gauteh/sonobuoy/doc/Instrument response/Response.pdf

Gautebøye - Instrument Response
Gaute Hope (gaute.hope@student.uib.no), 29.05.2012, Revision 3 (30.11.2012)

Introduction

Here is presented the theoretical derivation and analysis of the analog instrument response of the digitizer. The digital filtering during AD conversion is briefly discussed, but its properties are well defined in the manual of the ADC[ads1282ḋs ].

### 1 Hydrophone decoupling


Figure 1: Hydrophone decoupling circuit

The figure above (1) shows an equivalent circuit of the deployed input decoupling to the hydrophone.

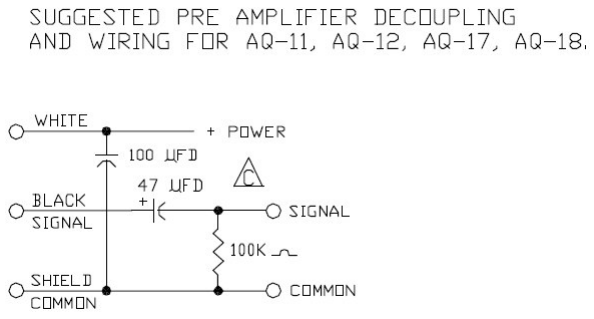
[picture p13: figure]

C1 = 47µF
C2 = 330pF
R1 = 58.33kΩ
R2 = 41.67kΩ

The circuit was based on the suggested decoupling in figure 2 seen below, it was designed to have the same properties, but also low-pass the signal at cutoff frequency fLP1
. The original design already decouples, and high-passes, the signal at frequency fHP .

1

Figure 2: AQ-18 suggested decoupling and wiring [aq-18ḋecoupling ].

### 2 Derivation of transfer function

i1 and i2 signify the current loops passing through respectively left and right loop. Using Kirchoff’s equation:

Vs = i1(ZC1 + ZR1

) + (i1 − i2) · ZR2

(1)
0 = (i2 − i1) · ZR2 + i2 · ZC2

(2)

Vs is the signal source, the hydrophone. See separate data sheet for hydrophone frequency response. Vo, output, is measured at the terminals T+ and

T−.

Vo = i2 · ZC2

(3)
H(s) = Vo
Vs
, s = iω | (4)

Solving for H(s) gives:

H(s) = | 51951s
(s + 1.2470 × 10⁵)(s + 0.2128) | (5)

A bode plot of the transfer function (instrument response) is shown in figure 3 below.


Figure 3: Bode plot of transfer function, showing peak response at 33.9 Hz.

Equation 5 can be solved by using the MATLAB script response.m (listing 1), the Bode plot in figure 3 was created with the same script.

### 2.1 Analysis

The initial frequency band of interest reaches from periods of 20 s (0.05 Hz) to approximately 100 Hz. The analog input part as well as the configuration of the analog-digital converter has been configured to as best and simple as possible to record the signal within this frequency band.

### 2.1.1 Decoupling and analog high pass fil-

ter

The transfer function is a bandpass filter with the suggested decoupling creating a high-pass filter with corner frequency at fHP = 0.0339 Hz or a period of 29.4985 s.

### 2.1.2 Low pass filter and operational am-

plifier

To avoid aliasing due to the speed of the opamps (operational amplifiers) in the signal path; the

2

OPA627 (see [opa627ḋs ] and figure 1) acting as buffer with unity gain and then the OPA1632 [opa1632ḋs ] at the input terminals of the ADS1282EVM [ads1282evmḋs ]. An additional low pass stage is added with a corner frequency of fLP1 = 17.189 kHz. The speed of the opamp is in the order of Mhz so this corner frequency should be well within their capabilities.

OPA1632
The OPA1632 [opa1632ḋs ] is set up with a 1 nF capacitor in its feedback loop on the ADS1282EVM [ads1282evmḋs ], this low passes the signal with an cut off frequency at fLP2 = 151.99 kHz. Its gain bandwidth is specified to be 180 MHz, given that the gain is 1 and the load is large it should have a well behaved and near ideal response. The OPA1632-setups simplified transfer function is [fullyḋiffȯpamps ]:

HOP A1632(s) = 9.551 × 10⁵
(s + 9.551 × 10⁵)

(6)

OPA627
The OPA627 is used as a buffer with gain 1 to provide a high impedance input and low impedance output. It has a gain bandwidth product of 16 MHz at this gain [opa627ḋs ]. With the first low pass filter, fLP1
, well below this it should be able to relay the signal without problems. The transfer function would simply be 1 for this step. It is important that the OPA627 has well mounted bypass capacitors to avoid oscillations when configured for this low gain. An buffer designed for unity gain, like the OPA633 [opa633ḋs ] or BUF634 [buf634ḋs ] could prove a better choice.

OPA633
The OPA633 [opa633ḋs ] is a strong candidate for an drop-in replacement of the OPA627, it is specifically designed to be a buffer working at unity gain. The feedback loop is internally connected. But otherwise the same wiring scheme applies. Closely mounted and well chosen bypass capacitors are still needed on the power supplies to ensure stability. The input impedance of the ADS1282EVM should be sufficient for the gain to approach unity. The OPA633 has a gain bandwidth of 260 MHz, however it requires ±15 mA current, which is about twice that of the OPA627.

### 2.1.3 Stability

The system, H(s) from equation (5), is passive and has all its poles in the left half plane and is stable.

### 2.1.4 Analog-Digital Converter (ADC)

The ADS1282EVM equips its ADS1282 with a crystal with the recommended clock frequency of fclk = 4.096 Mhz [ads1282evmḋs ]. This results in a modulator output speed of fs = fclk/4 = 1.024 Mhz [ads1282ḋs ]. The Nyquist frequency is then:

fN q = 1.024 × 10⁶
/2 = 512 kHz | (7)

3


Figure 4: Frequency response of complete analog system, equation (9).

### 2.1.5 Anti-alias filter

The 10 nF capacitor used on the ADS1282EVM [ads1282evmḋs ], results in a low-pass filter with an upper corner frequency of fLP3 =
1
2π×600×10×10⁻⁹ = 26525.82 Hz 1

fLP3

is thus well below fN q and any signal component above fLP3
should be almost completely damped before it reaches fN q, resulting in no or very small aliasing effects.
This equation represents the upper low pass filter:


HUL(s) = | 1 ÷ 600 × 10 × 10⁻⁹
| (s + 1 ÷ 600 × 10 × 10⁻⁹)
= | 1.667 × 10⁵
| (s + 1.667 × 10⁵)

(8)

The complete analog transfer function is then:

Ha =

8.2698 × 10¹⁵s
(s + 9.551 × 10⁵) × (s + 1.667 × 10⁵)

×

1
(s + 1.247 × 10⁵) × (s + 0.2128)

(9)

The frequency response is illustrated in figure (4).

### 2.1.6 Output of decoupling and buffer

The output is scaled by −7.6 dB = 0.4169 V
V
which is to scale the input from ±6V to ±2.5V , 0.4169 ≈ 5/12 = 0.4167, which is the input range of the ADS1282EVM ([ads1282evmḋs ] and [ads1282ḋs ]) in bipolar mode. The slightly inaccurate scaling is due to the available (high precision) resistor values.

The impulse response of the system is plotted in figure 5:

1Equation (3), p.15, [ads1282ḋs ]; ads1282ḋs

4

Figure 5: Impulse response of complete analog system, equation (9).

The step response, large is plotted in figure 6:


Figure 6: Step response of complete analog system, equation (9).

A | zoomed | in | section | of | the | high
frequency | response | is | shown | in | fig-
ure | 7, | the | first | tens | of | microseconds.


Figure 7: Step response (zoomed) of complete analog system, equation (9).

Attenuation at Nyquist frequency
The attenuation at the Nyquist frequency, 512 kHz, equation (7) using (9), is evaluated to be:

|Ha(512 × 10³ × 2π)| = 0.00023763

= −72.4821 dB

(10)

The theoretical maximum dynamic range is specified to be 130 dB²
. But before reaching the frequencies of any signals not attenuated at (10) that wraps around to the 125 Hz passband of the digital filter (section 7) they will be additionally attenuated. The next periods will be increasingly attenuated.

Depending on the noise spectra there will be only a fraction of the noise that is in this passband. Any tones or oscillations from the electrical components or environment are, although unlikely to be entirely in this passband, the biggest worry. Other noise is likelier to have a flatter spectra, where only a fraction of its amplitude will wrap into the 125 Hz passband.

### 3 Digital filter

Further the ADS1282 is configured to digitally filter the decimation output so that the final output signal of 250 Hz contains no alias below the input Nyquist sample rate (equation (7)). The built-in sinc and FIR filters are activated, see the ADS1282 datasheet [ads1282ḋs ] for details. This provides more than 140 dB of attenuation above the Nyquist frequency of the output sample rate [ads1282ḋs ].

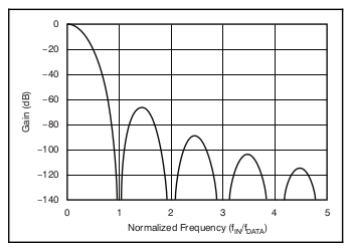
[picture p14: figure]

Figure 8: Sinc filter response [ads1282ḋs ].

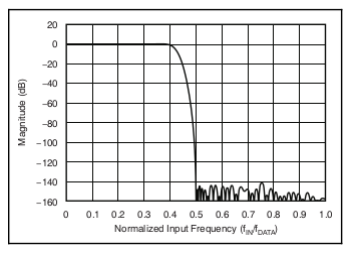
[picture p15: figure]

Figure 9: FIR filter response [ads1282ḋs ].

Figure 8 shows the response of the sinc filter, figure 9 shows the response of the FIR filter (figures from ads1282ḋs pp. 20 - 21 [ads1282ḋs ].

The ADS1282 can be configured for an sample rate of as high as 4000 Hz [ads1282ḋs ]. This would be possible without changes in the analog

2Table 1, p. 13, [ads1282ḋs ]; ads1282ḋs

5

interface, although it would come at an cost of resolution and would require adaption of the firmware of the buoy to handle the higher data rate.
High Pass Filter (HPF) The ADS1282 is configured to have an high pass corner frequency as close to 20 seconds as possible, the built in IIR HPF is set according to p. 22 in ads1282ḋs

HP F[1 : 0] = 65, 536×
"
1 −

s
1 − 2

cos(ωn) + sin(ωn) − 1
cos(ωn)
(11)

with:

ωn = 2πfHP /fDAT A | (12)
An fHP | = 1/20 = 0.05 Hz gives an ωn | =
0, 001256637 normalized radians. And an HP F[1 : 0] = 82.3550098 truncated to HP F[1 : 0] = 8210 = 5216.

### 4 Hydrophone characteristics

The | hydrophone | used, | Benthos | AQ-18, | is
specified to have an flat frequency response within ±1.5dB at the band 7 Hz - 10 kHz [benthosḣydrophoneḃrochure ]. With a sensitivity of -171 dBv re 1 uPa at 20◦ C.

The frequency response for the AQ-18 is plotted in figure 10:

Figure 10: Frequency response plot of hydrophone, AQ-18 [communicationḃenthosȧq18ḟreq ].

A simplified transfer function for the hydrophone in the flat band (7 Hz - 10 kHz):

HHyd = −171 dBv re 1 uPa = 10⁸.55 V uPa (13)

### 5 Response of Digitizer

The AD converter, ADS1282, includes very sharp digital filters (section 3). The output is 32 bit integers, with a range of -−2

31
, 2

31 − 1

. The result is
a near approximately flat frequency response from 0.05 Hz up to 125 Hz.

HD =

2

32
5

counts
V

(14)

### 6 Response compared to output of a

seismometer

The hydrophone measures pressure (uPa) while the seismometer measures displacement (nm), to be able to compare these some relation has to be figured out.

Considering that a force is exerted proportional to the pressure the hydrophone is measuring and that acceleration is proportional to force the simplest is to consider the hydrophone an accelerometer.

6

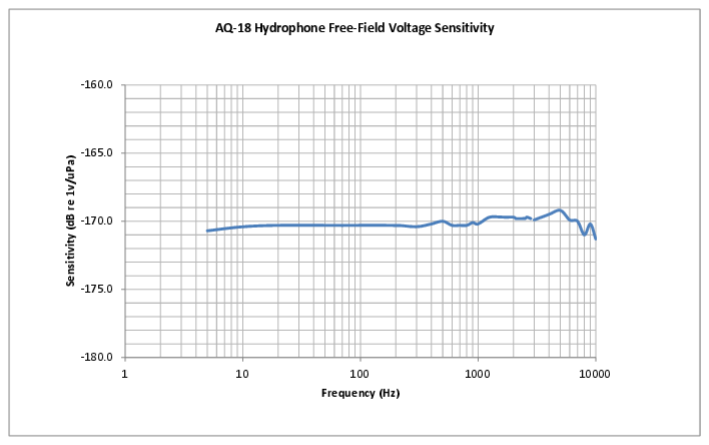
[picture p16: figure]

### 7 Attachments

### 7.1 response.m

Listing 1: response.m, MATLAB code for calculating instrument response

1 | % Calculates instrument response
2 | r1 = 58.33e3; | % ohm
3 | r2 = 41.67e3; | % ohm

4
5 | c1 = 47e-6; | % farad
6 | c2 = 330e-12; | % farad

7
8 | %% Transfer function of Hydrophone decoupling, including first high pass and low
9 | % | pass filters and OPA629.

10
11 | syms s i1 i2 vs;
12 | zc1 = 1/(s*c1);
13 | zr1 = r1;
14 | zc2 = 1/(s*c2);
15 | zr2 = r2;

16
17 | [i1, i2] = solve ('vs = i1*(zc1 + zr1) + (i1 - i2)*zr2', ...
18 | '0 | = (i2 - i1)*zr2 + i2*zc2', 'i1', 'i2');
19 | %i2 = solve ('vs = i2*(zc1 + zr1 + zr2)', 'i2');

20
21 | vo = i2*sym('zc2');
22 | H | = vo/vs;
23 | H | = simplify(subs (H));

24
25 [n, d] = numden (H);

26
27 | Tn = sym2poly(n);
28 | Td = sym2poly(d);
29 | T = tf(Tn, Td);

30

31
32 | P = bodeoptions;
33 | P.FreqUnits = 'Hz';
34 | figure(1); clf('reset');
35 | bodeplot (T, P);
36 | title ('Bode plot of hydrophone decoupling with initial low pass and OPA629');

37
38 | disp ('Hydrophone decoupling up to OPA629:')
39 | zpk(T)
40 | if isstable(T)
41 | disp ('System is stable.');
42 | else
43 | disp ('System is unstable.');
44 | end

45
46 | %% opa1632 low pass
47 | disp ('OPA1632. low passing:');
48 | UOPA = zpk([], [-(1/(1047*10ˆ-9))], 1/(1047*10ˆ-9))
49 | figure(4); clf('reset');
50 | bodeplot (UOPA, P);
51 | title ('Bode Diagram (OPA1632)');

52
53 | %% upper low pass
54 | disp ('Upper low pass (ADS1282, analog):');
55 | U = zpk([], [-(1/(600*10*10ˆ-9))], 1/(600*10*10ˆ-9))
56 | figure(2); clf('reset');
57 | bodeplot (U, P);
58 | title ('Bode Diagram (Upper low pass filter)');

59
60 | %% final response
61 | disp ('Final response:');
62 | C = UOPA * U * T
63 | figure(3); clf('reset');

7

64 | bodeplot (C, P);
65 | title ('Bode Diagram (Complete analog response)');

66
67 | % Stable
68 | if isstable(C)
69 | disp ('System is stable.');
70 | else
71 | disp ('System is unstable.');
72 | end
73 | figure(5);
74 | [p, z] = pzmap(C);
75 | pzmap(C);
76 | disp ('Poles:')
77 | disp(p)

78
79 | % attenuation at nyquist
80 | disp ('Attenuation at Nyquist:');
81 | a = abs(freqresp(C, 512e3*2*pi))
82 | adb = 20*log10(a)

8
