gauteh/sonobuoy/zero/README.txt

Contents:

  zero.py:
  Central logging point (Zero), manages buoys, synchronizes and
  retrieves status.

  ztool.py:
  Command line interface for sending commands, retrieving status and
  monitoring buoys from Zero.

  log/:
  Local storage of buoy data, Zero writes data here.

  snap/:
  Firmware for RF200 connected for RF200 device connected to Zero
  through USB.

  storetools/:
  Tools for processing data files.

  matlab/:
  Scripts for working with data files in MATLAB.

  utils/:
  Scripts and programs for preparing SD card, backing up and testing.

  zui/:
  Unfinished graphical user interfaces.
