gauteh/sonobuoy/doc/Instrument response/pzmap.png

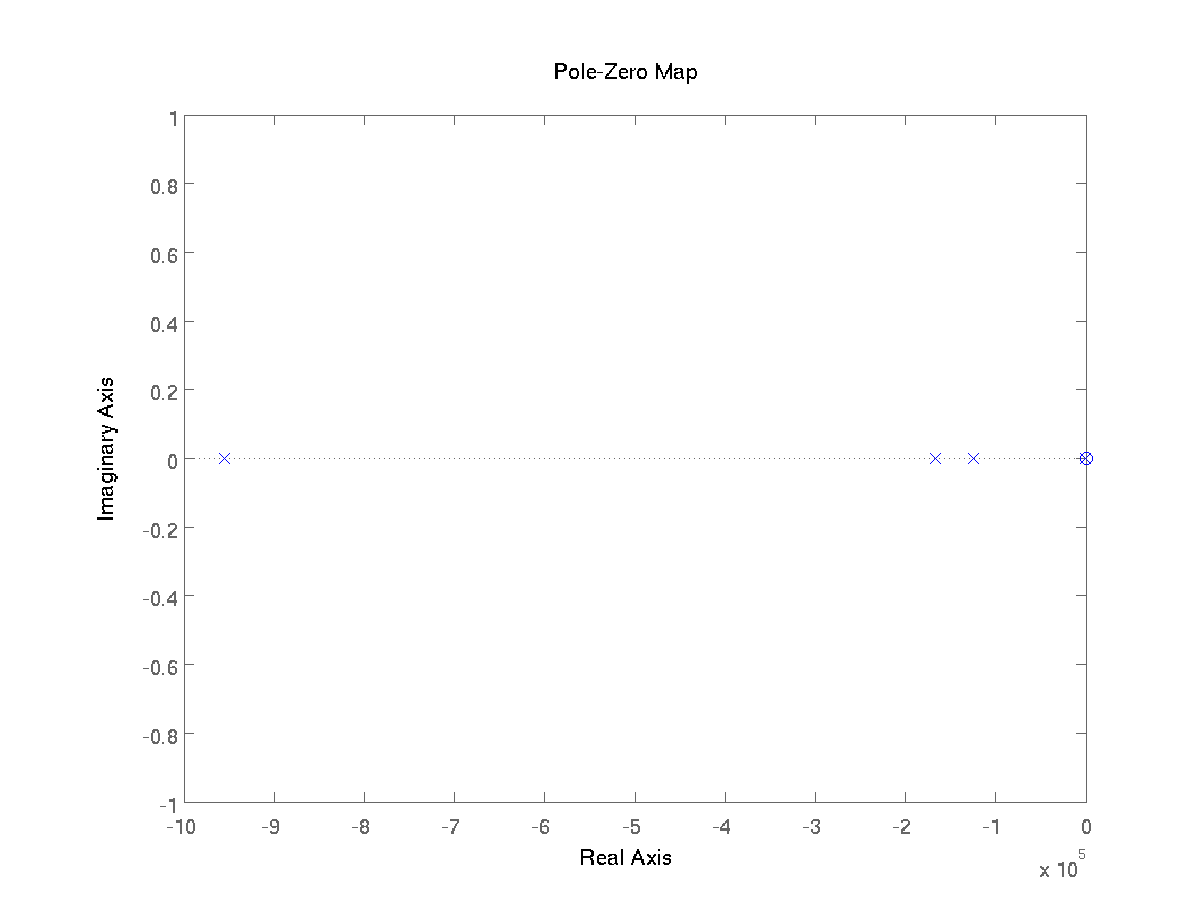
doc/Instrument response/pzmap.png
