gauteh/sonobuoy/hardware/Parts.ods

 | Node component list
Qty | Part no. | Name | Comment | NOK | USD | Supplier
1 |  | Olimexino STM32 H103 |  |  | $75,00 | Mouser
1 | EM-406A SiRF III | GPS with PPS |  | kr 443,00 |  | ELFA
1 | RF200PD1 | Synapse RF transciever |  |  | $27,00 | Future Electronics / Solarobotics
1 | 39252 | Synapse Breakout Board |  |  |  | Solarobotics
 | SN171GG-N | SNAP ProtoBoard |  |  | $42,00 | Future Electronics
 |  | RF power amplifier |  |  | $180,00 | Radiolabs
1 |  | RF Antenna 15 dBi Omnidirectional |  |  | $150,00 | Radiolabs
1 |  | 16 GB microSD card (high quality) |  |  | $33,00 | Komplett
1 | ADS1282EVM | ADC 24bit evaluation board |  |  | $49,00 | Mouser
2 | TSS-110-03-L-D | ADS1282EVM Headers 20 pin |  |  |  | Samtec
1 | TSS-105-03-L-D | ADS1282EVM Headers 10 pin |  |  |  | Samtec
1 |  | Hydrophone
1 |  | Battery 12V 100Ah |  |  | $250,00
1 |  | Box
 | Power regulation and preamp/buffer
1 | TEN 5-1222 | DC / DC 9 – 18 -> +/- 12V |  |  | $86,00 | ELFA
1 | LM2674N-5.0 | Switching voltage reg +5V |  |  |  | Mouser
1 | TL751L | Voltage reg +10V |  |  |  | Mouser
1 | LM2991 | Voltage reg -10V |  |  |  | Mouser
1 | LF60ABV | Voltage reg +6V |  |  |  | Mouser
1 | LM2991 | Voltage reg -6V |  |  |  | Mouser
1 | TLE2426 | Virtual ground (Agnd) |  |  |  | Mouser
1 |  | Voltage reg -5V |  |  |  | Mouser
2 | 1 uF | Solid Tantulum | LM2991
2 | 2,4kOhm | Adjustment (1%) | LM2991
1 | 9,5kOhm | Adjustment (1%) | LM2991 (-6V)
1 | 17,6kOhm | Adjustment (1%) | LM2991 (-10V)
1 | Diode 50V, 3.3A | Schottky 50V, 3.3A | LM2674 |  |  | IR30WQ05F
1 | 22 uF | 50V Tantulum (Cin) | LM2674 |  |  | Sprague 199D series
1 | 100 uF | 25V Tantulum (Cout) | LM2674 |  |  | Sprague 595D series
1 | 68 uH | Sumida (Lout) | LM2674
1 | 0.01uF | 50V Ceramic (Cb) | LM2674
1 | 10 uF | Cin | LF60ABV
1 | 2.2uF | Cout | LF60ABV
1 | 41.67 kOhm | Voltage scaling, preamp (hi-prec) | Preamp
1 | 58.33 kOhm | Voltage scaling, preamp (hi-prec) | Preamp
1 | 380 pF | LP filter preamp | Preamp
2 | 0.1 uF | Opamp power bypass | Preamp
2 | 2.2uF | Opamp power bypass | Preamp
1 | OPA620 | Buffer (alt: LM833N) | Preamp |  |  | Mouser
2 | 4,7kOhm |  | Pull-up I2C
2 | 100 uF
 | Logging point component list
1 | RF200PD1 | Synapse RF transciever |  |  | $40,00 | Future Electronics / Solarobotics
1 |  | RF Antenna 15 dBi Omnidirectional |  |  | $150,00 | Radiolabs
1 |  | RF power amplifier |  |  | $180,00
1 | SN132HO-NR | SNAPStick USB module |  |  | $37,23 | Future Electronics
 |  | Logging computer (Linux)
