gauteh/sonobuoy/hardware/Olimexino - pin map and configuration.ods

Olimexino pin map
Olimexino
GND | DGND
Vin | +12V
RST | Reset | 20 | RF200, GPIO18 | Active LOW, break out to shield and to RF200
RF200 |  | Olimexino |  | USART1
Pin | Pin name | Pin | Pin name
GPIO8 | TX (XBTX) | 8 | 1_RX
GPIO7 | RX (XBRX) | 7 | 1_TX
GPIO18 | [20] | RST | Reset
Vdd | +3.3V
GND | DGND
GPS |  | Olimexino |  | USART2
Pin | Pin name | Pin | Pin name
1, Black | DGND
2, White | +5V
3, Yellow | RX | NC
4, Blue | TX | 0 | 2_RX | 5V tolerant
5, Red | DGND
6, Green | PPS | 2 | Interrupt, EXTI0 | 5V tolerant | EXTI: D2, D15, D27
SD |  | Olimexino |  | SPI2
Pin | Pin name | Pin | Pin name
MOSI |  | 33 | 2_MISO | 5V tolerant | Onboard SD-header on SPI2
MISO |  | 34 | 2_MOSI
SS |  | 25
SCK |  | 32 | 2_SCK
ADS1282EVM |  | Olimexino |  | I2C1, SPI1
Pin | Pin name | Pin | Pin name
J5.9 | nDRDY | 4 | Interrupt, EXTI5 |  | EXTI: D4, D13, D20
J5.3 | SCLK | 12 |  |  | SPI
J5.11 | DIN | 10
J5.13 | DOUT | 11
J5.16 | SCL | 5 | 1_SCL | Pullup to 3.3V | I2C
J5.20 | SDA | 9 | 1_SDA | Pullup to 3.3V
Analog inputs
J6.1 | A1N | Vref | TLE2426 | Agnd
J6.2 | A1P | Vs | Opamp output | Agnd +/-2.5V
Power |  | Board | Olimexino
J8.1 | +10VA | +10VA |  |  | Power supply
J8.2 | -10VA | -10VA
J8.3 | +5VA | +5VD |  | (max. +5V)
J8.4 | -5VA | -6VA |  | (min. -10V)
J8.5 | DGND | DGND |  | Is not used for Avss internally
J8.6 | AGND
J8.7 | +1.8VD | NC
J8.8 | VD1 | NC
J8.9 | +3.3V | +3.3V | Vcc (3.3V)
J8.10 | +5V | NC
Jumpers and switches
J1 | REF | 1&2 | Set on-board reference to output of REF5050
J2 | CLK | 1&2 | Use on-board clock to drive ADS1282
J3 | CLKSEL | 2&3 | Set to DVDD (always on), turn on-board clock on
S1 | S1 | Onbrd | Use on-board reference
J10 |  | 1&2 | Enable DIN
J7.12 | ADC_AVDD | Yes | Power +5V to +2.5V
J7.34 | ADC_AVSS | Yes | Power -5V to -2.5V
J7.56 | +3.3V | Yes | Has 3.3V digital supply
J7.78 | AGND | Yes | Agnd = Dgnd, internally new Avss is created from +/-5VA
J7.910 | DGND | Yes
