gauteh/sonobuoy/hardware/MapleNativeBeta - pin map and configuration.ods

Maple Native Beta pin map
Maple
GND | DGND
Vin | +5V | (or as close to +3.3V as possible)
RST | Reset | Active low, break out to shield
RF200 protoboard |  | Maple
GPIO8 | TX | 1 | RX3
GPIO7 | RX | 0 | TX3
Vext | +5V
GND | DGND
GPS |  | Maple
Black | DGND
White | +5V
Yellow | NC
Green | PPS | 25 | Interrupt
Blue | DGND
Red | TX | 27 | RX5
SD |  | Maple
+5V | +5V
GND | DGND
MOSI |  | 5 | MISO
MISO |  | 4 | MOSI
SS |  | 2 | SS
SCK |  | 3 | SCK
ADS1282EVM |  | Maple
J5.3 | SCLK | 53 | SCLK |  | Serial interface
J5.9 | nDRDY | 40 | Interrupt
J5.11 | DIN | 54 | DIN (output)
J5.13 | DOUT | 55 | DOUT (input)
J5.16 | SCL | 38 | I2C clock | Pullup to 3.3V
J5.20 | SDA | 39 | I2C data | Pullup to 3.3V
Analog inputs
J6.1 | A1N | Vref | TLE2426 | GND +6V
J6.2 | A1P | Vob | Opamp output | GND +6V (+-2.5V)
Power |  |  | Maple
J8.1 | +10V | +6V |  |  | Power supply
J8.2 | -10V | -6V
J8.3 | +5V | +6V
J8.4 | -5V | -6V
J8.5 | DGND | DGND
J8.6 | AGND | DGND
J8.7 | +1.8VD | NC
J8.8 | VD1 | NC
J8.9 | +3.3V | +3.3V | Vcc (3.3V)
J8.10 | +5V | NC
Jumpers and switches
J1 | REF | 1&2 | Set on-board reference to output of REF5050
J2 | CLK | 1&2 | Use on-board clock to drive ADS1282
J3 | CLKSEL | 2&3 | Set to DVDD (always on), turn on-board clock on
S1 | S1 | Onbrd | Use on-board reference
J10 |  | 1&2 | Enable DIN
J7.12 | ADC_AVDD | Yes | Power +5V to +2.5V
J7.34 | ADC_AVSS | Yes | Power -5V to -2.5V
J7.56 | +3.3V | Yes | Has 3.3V digital supply
J7.78 | AGND | Yes | Use AGND as DGND
J7.910 | DGND | No | Connected by J7.78
