gauteh/sonobuoy/doc/Protocol.ods

Protocol
Buoy, receive | Version | Token | Arguments
GETSTATUS | 1 | GS |  |  |  |  | Returns an AD,S and GPS,S message
GETINFO | 2 | GIF |  |  |  |  | Returns info about buoy
GETIDS | 1 | GIDS | id |  |  |  | Returns IDS message starting from specified ID up to pre-determined number of IDS
GETLASTID | 1 | GLID |  |  |  |  | Returns an LID message
GETBATCH | 1 | GB | id | ref no | start | length | Returns an AD,D message, batch and AD,DE message
 |  |  | Send samples from index and datafile with 'id' | Start from reference number in datafile 'id' | Send samples from 'start' sample relative to reference number | Send 'length' number of samples from 'start' | With a length longer than one batch (reference) the following are sent subsequentially – if the length exceeds the number of references (batches) on this ID a E_NOSUCHREFERENCE error is sent. And no batches are sent.
Deprecated:
GETID | 1-3 | GID | id |  |  |  | Return IND message
Buoy, transmit | Version | Token | Values
GETSTATUS
AD STATUS | 1 | AD,S | queue position | batch fill time | current value
GPS STATUS | 1 | GPS,S | last telegram type | No of received telegrams | latitude | north / south | longitude | east/west | lastsecond | time | date | valid | HAS_TIME | HAS_SYNC | HAS_SYNC_REFERENCE
 |  |  |  |  |  | 'N' or 'S' |  | 'E' or 'W' | Time and date converted to unix time, possibly updated by PPS pulse. Used for reference. |  |  | GPS fix reported valid by GPS | True if current reference has valid time | True if there is a valid PPS signal | True if reference could be set by valid time and PPS signal
GPS STATUS | 2 | GPS,S | last telegram type | No of received telegrams | latitude | north / south | longitude | east/west | lastsecond | time | date | valid | HAS_TIME | HAS_SYNC | HAS_SYNC_REFERENCE | uptime
 |  |  |  |  |  | 'N' or 'S' |  | 'E' or 'W' | Time and date converted to unix time, possibly updated by PPS pulse. Used for reference. |  |  | GPS fix reported valid by GPS | True if current reference has valid time | True if there is a valid PPS signal | True if reference could be set by valid time and PPS signal | Millis (), will wrap around eventually, returns ms since start
GETINFO
INFO | 2 | I | buoy id | buoy version | protocol version
INFO | 3 | I | buoy id | buoy version | protocol version | store version
GETLASTID
LAST ID | 1 | LID | current id
GETID
INDEX (header) | 1 | IND | id | samples | no of refs
INDEX (header) | 3 | IND | id | store version | samples | no of refs
INDEX (header) | 4 | IND | id | store version | samples | no of refs | sd lag
GETBATCH
Start of data | 1 | AD,D | id | refno | start | length | ref | refstat | latitude | longitude | checksum (32bit)
 |  |  |  |  |  |  | Both ref and refstat is 0 if start != 0, 32 bit checksum is recorded by ads1282 and stored along with the reference
Start of sampels |  | $ |  |  |  |  | Signals start of binary data, no following newline
Samples (binary) |  |  |  |  |  |  | Samples sent as binary data, length * sample length (4 bytes) must be read.
End of data |  | AD,DE | checksum |  |  |  | Checksum XOR of binary data, 8 bit
Error messages:
ERROR | <=1 | $ERR | error code
ERROR | 2 | $ERR | buoy id | error code
Error codes (defined in rf.h and buoy.py):
E_CONFIRM | 1 |  | 0 | Not used
E_BADCOMMAND | 1 |  | 1 | Bad arguments have been given or the command can somehow not be executed
E_UNKNOWNCOMMAND | 1 |  | 2 | An unknown command
E_SDUNAVAILABLE | 1 |  | 3 | The SD card is not available, reflects: store->SD_AVAILABLE
E_NOSUCHID | 1 |  | 4 | The id requested (e.g. by GETID or GETBATCH) does not exist
E_NOSUCHREF | 1 |  | 5 | The ref requested by GETBATCH does not exist
E_NOSUCHSAMPLE | 1 |  | 6 | The sample does not exist, the data file does not contain enough samples
E_NOSUCHDAT | 1 |  | 7 | The dat file does not exist or cannot be opened
E_BADDAT | 1 |  | 8 | There was an error reading and sending the DAT file
E_SDLAG | 1 |  | 9 | SD card could not write queue fast enough, samples may be out of sync and lost.
E_MAXIDREACHED | 2 |  | 10 | The highest ID has been reached, the latest will be overwritten on each new file.
Deprecated:
GETREFS
REFERENCES of ID | N/A | REF | id | ref no | ref
GETIDS
LIST OF IDS | 1-3 | IDS | id | enabled |  |  | Enabled (1 or not: 0) indicates wether this index/datafile exists
