gauteh/sonobuoy/doc/Operators manual/OperatorsManual.pdf

Gautebøye - Operators manual
Gaute Hope (gaute.hope@student.uib.no), 02.09.2012, Revision 1

Introduction

This document describes how to install and operate a network of Gautebøyer.

### 1 Installation

### 1.1 Central logging point: Zero

Zero is the central logging point and is started by running the script ’zero/zero.py’ from the command line.

### 1.1.1 ZeroNode

For the central logging point you need a computer connected to an RF200 node through USB with the snap script ’zero/snap/zeronode.py’ installed.

### 1.2 Buoy

### 2 Monitoring

1
