gauteh/sonobuoy/hardware/Power measurements, Olimexino.ods

Power circuit, rev 2
Incremental measurements while prototyping circuit, source: 12V DC, measured value is output current on source.
Part | mA | Rated efficiency | Comment
TEN 5-1222 | 20 | 84
TL751L (+10V LDO) | 10
LM2674N-5.0 (+5V Switch reg)
LF60ABV (+6V LDO)
LM2991 (-10V LDO) | 5 |  | (using 2,4k and 1,76k adjustment resistors)
LM2991 (-6V LDO) |  |  | (using 2,4k and 9,5k adjustment resistors)
Olimexino STM32 H103 | 40 |  | (no processing)
TLE2426 (Avss) | 0
Sum | 75
TEN 5-1222 | 70
TL751L (+10V LDO)
78SR105 (+5V Switch reg)
Olimexino STM32 H103
LM2991 (-10V LDO) | 10
LM2991 (-6V LDO)
LF60ABV (+6V LDO)
TLE2426 (Avss)
ADS1282EVM | 80 |  | (full operation) (using +/- 12V and a LDO -5V gives ca same result)
SD card | 0
GPS | 20 |  | No fix
RF | 30 |  | (full operation)
Preamp + Hydrophone | 10
Sum | 220
