gauteh/sonobuoy/hardware/Power measurements, MapleNativeBeta.ods

Power budget [mA]
 | 3,3 | -5 | 5 | -12 | 12
Power rails
Sum | 0 | 0 | 0 | 0 | 0
Power | 0 | 0 | 0 | 0 | 0
Current (at 12V) | 0 | 0 | 0 | 0 | 0
Measured (peak) |  |  |  |  |  | Idle
 | 3,3 | -5 | 5 | -12 | 12 | 3,3 | -5 | 5 | -12 | 12
RF200 |  |  | 35 |  |  |  |  | 35
RF200 protoboard
GPS |  |  | 55 |  |  |  |  | 55
SD card |  |  | 22 |  |  |  |  | 9
ADS1282-EVM (analog) |  | 0 | 8
Maple Native |  |  | 112 |  |  |  |  | 112
ADS1282-EVM (digital) | 60
ADS1292-EVM (opamp) |  |  |  | -30 | 34
Hydrophone w/ preamp
Opamp / buffer |  | -4,3 | 4
Sum | 60 | -4,3 | 201 | -30 | 34 | 0 | 0 | 176 | 0 | 0
Power | 198 | 21,5 | 1005 | 360 | 408 | 0 | 0 | 880 | 0 | 0
Current (at 12V) | 16,5 | 1,79 | 83,75 | 30 | 34 | 0 | 0,00 | 73,33 | 0 | 0
External input (12V) | 370
From 12/12 DC summing
Maple Native | 90
RF200 | 120
ADS1282EVM | 160 | 230
SD |  | 240
GPS |  | 300
