gauteh/sonobuoy/doc/Buoys/Tests/One/1hz_10_hz_squarewaves.png

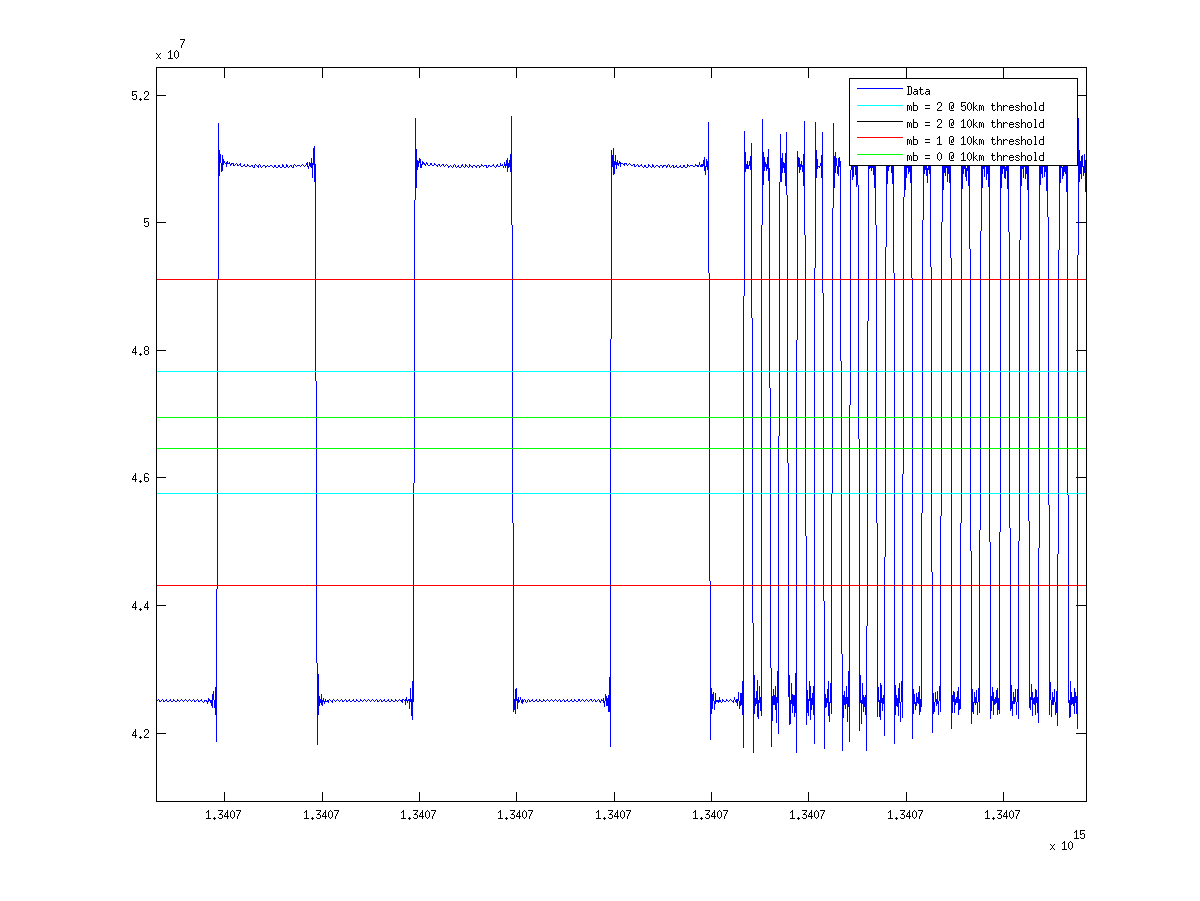
doc/Buoys/Tests/One/1hz_10_hz_squarewaves.png
