gauteh/sonobuoy/doc/Instrument response/aq-18/AQ-18 FFVS.PDF

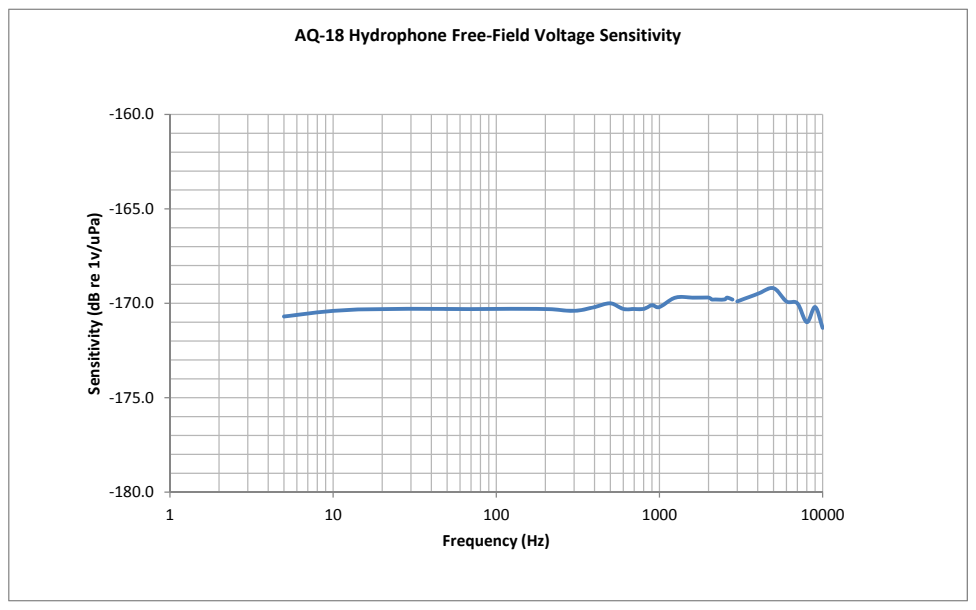
[picture p19: page 1]
Frequency (Hz)

AQ‐18 Hydrophone Free‐Field Voltage Sensitivity

Sensitivity (dB re 1v/uPa)
