gauteh/sonobuoy/doc/Instrument response/aq-18/AQ-18 Receive Voltage Sensitivity.pdf

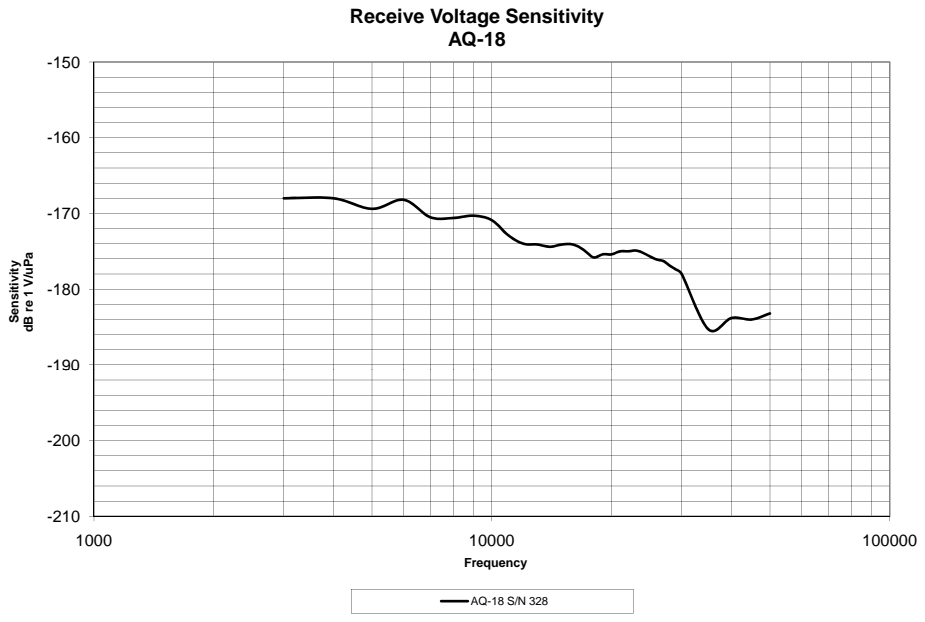
[picture p20: page 1]
Sensitivity; Frequency

Receive Voltage Sensitivity

dB re 1 V/uPa
