gauteh/sonobuoy/buoy/gps.cpp

/* Author:  Gaute Hope <eg@gaute.vetsj.com>
 * Date:    2012-01-31
 *
 * Interface to standard NMEA GPS.
 *
 *
 */

# include <stdint.h>
# include <stdlib.h>
# include <string.h>

# include "buoy.h"

# include "gps.h"
# include "ads1282.h"

using namespace std;

namespace Buoy {
  GPS::GPS () { // {{{
    HAS_TIME = false;
    HAS_SYNC = false;
    HAS_SYNC_REFERENCE = false;

    lastsecond      = 0;
    lastsecond_time = 0;

    reference       = 0;
    microdelta      = 0;

    lastmicros      = micros ();
    lastsync        = 0;

    received  = 0;
    lasttype  = UNSPECIFIED;
    time      = 0;
    hour      = 0;
    minute    = 0;
    second    = 0;
    seconds_part = 0;
    day       = 0;
    month     = 0;
    year      = 0;
    valid     = false;
    *latitude = 0;
    north       = false;
    *longitude  = 0;
    east        = false;

    ref_latitude[0]   = 0;
    ref_longitude[0]  = 0;
    ref_position_lock = 0;

    //*speedoverground = 0;
    //*courseoverground = 0;
  } // }}}

  void GPS::setup (BuoyMaster *b) { //{{{
    ad = b->ad;

    gps_buf[0] = 0;
    gps_buf_pos = 0;

    GPS_Serial.begin (GPS_BAUDRATE);

# if DEBUG_VERB
    SerialUSB.println ("[GPS] Waiting for first (un-reliable) reference..");
# endif
    uint8_t n = 0;
    while (lastsecond == 0) {
      loop ();
      delay (100);

      /* Break after 100 secs */
      if (n > 1000) {
# if DEBUG_VERB
        SerialUSB.println ("[GPS] [Error] No initial reference received for 100 sec.");
# endif
        break;
      }
      n++;
    }

    /* Setting initial un-reliable reference */
    reference   = lastsecond;
    microdelta  = micros ();
    lastsync    = millis ();
    lastmicros  = micros ();

    pinMode (GPS_SYNC_PIN, INPUT_PULLDOWN);
    enable_sync ();
  } //}}}

  void GPS::sync_pulse_int () {
    bu->gps->sync_pulse ();
  }

  void GPS::sync_pulse () {
    /* If a PPS pulse is sent it must be for the second after the last
     * received as a telegram.
     *
     * According to RFC2783 (http://tools.ietf.org/html/rfc2783) the timestamp
     * for a PPS will arrive _after_ the pulse.
     *
     */
    lastsecond++;

    /* New available reference */
    reference  = lastsecond;

    /* Update microdelta */
    microdelta = micros ();

    /* Reset last sync counter */
    lastsync   = millis ();

    HAS_SYNC            = true;
    HAS_SYNC_REFERENCE  = true;
  }

  void GPS::assert_time () { // {{{
    /* Check state of timing and PPS, is called from within interrupt.
     * Should not output */

    /* Check if we have lost sync */
    if ((millis () - lastsync) > LOST_SYNC) {
      HAS_SYNC = false;

      /* Check if we need to manually update reference:
       *
       * If micros () has overflowed since last microdelta and reference,
       * a new reference and microdelta must be set before it reaches the
       * second overflow.
       *
       * By ensuring that the reference is updated within the roll over time
       * for micros () this should not happen.
       *
       */

      /* Assuming we cannot have sync without time, there cannot be a lost
       * sync_reference without lost sync */
      if ((millis ()  - lastsync)  > (REFERENCE_TIMEOUT * E3))
      {
        HAS_SYNC_REFERENCE = false;

        /* Un-reliable, using time telegram */
        reference   = lastsecond;
        microdelta  = lastmicros;
        lastsync    = millis ();
      }
    }
  } // }}}

  void GPS::update_second () {
    /* Calculate Unix time {{{ */
    # define SECONDS_PER_DAY 86400uL
    # define LEAP_YEAR(x) !!(!((1970 + x) % 4) && ( ((1970 + x) % 100) || !((1970 + x) % 400) ))

    uint32_t _year = (2000 + year) - 1970; // Offset 1970 (unix epoch)

    uint64_t newsecond = _year * 365 * SECONDS_PER_DAY;

    # define LEAP_YEARS_BEFORE_1970 ((1970 / 4) - (1970 / 100) + (1970 / 400))
    /* Add a day of seconds for each leap year except this */
    newsecond += ((  (1970 + (_year-1)) /   4 )
               -  (  (1970 + (_year-1)) / 100 )
               +  (  (1970 + (_year-1)) / 400 )
               -  LEAP_YEARS_BEFORE_1970       ) * SECONDS_PER_DAY;

    const int monthdays[12] = {31, 28, 31, 30, 31, 30, 31, 31, 30, 31, 30, 31};
    for (int i = 1; i < month; i++) {
      if ((i == 2) && LEAP_YEAR(_year))
        newsecond += SECONDS_PER_DAY * 29;
      else
        newsecond += SECONDS_PER_DAY * monthdays[i - 1];
    }

    newsecond += SECONDS_PER_DAY  * (day - 1);
    newsecond += (uint32_t)hour   * 60 * 60;
    newsecond += (uint32_t)minute * 60;
    newsecond += (uint32_t)second;

    time  = hour    * E4;
    time += minute  * E2;
    time += second;

    /* Make sure the PPS interrupt is not run while working */
    disable_sync ();

    /* Update last second */
    lastsecond_time = millis ();
    lastmicros      = micros ();
    lastsecond      = newsecond;

    HAS_TIME = valid;

    /*
    SerialUSB.println ((char*) ref_latitude);
    SerialUSB.println ((char*) ref_longitude);
    SerialUSB.println (HAS_SYNC);
    */

    enable_sync ();
    // }}}
  }

  void GPS::update_ref_position () { // {{{
    for (uint8_t i = 0; i < 12; i++) {
      ref_latitude[i] = 0;
      ref_longitude[i] = 0;
    }

    strcpy ((char*) ref_latitude, latitude);
    volatile char * t = ref_latitude;
    while (*t != 0 && t < &(ref_latitude[11]))
      t++;
    if (north)  *t = 'N';
    else        *t = 'S';

    strcpy ((char*) ref_longitude, longitude);
    t = ref_longitude;
    while (*t != 0 && t < &(ref_longitude[11]))
      t++;
    if (east) *t = 'E';
    else      *t = 'W';
  } // }}}

  void GPS::loop () {
    /* Handle incoming GPS telegrams on serial line (non-blocking) {{{
     *
     *
     * States:
     * 0 = Waiting for start of telegram $
     * 1 = Receiving (between $ and *)
     * 2 = Waiting for Checksum digit 1
     * 3 = Waiting for Checksum digit 2
     */
    static int state = 0;

    int ca = GPS_Serial.available ();

    while (ca > 0) {
      char c = (char)GPS_Serial.read ();

      if (gps_buf_pos >= (TELEGRAM_LEN + 2)) {
        state = 0;
        gps_buf_pos = 0;
      }

      switch (state)
      {
        case 0:
          if (c == '$') {
            gps_buf[0]  = '$';
            gps_buf_pos = 1;
            state = 1;
          }
          break;

        case 2:
          state = 3;
        case 1:
          if (c == '*') state = 2;

          gps_buf[gps_buf_pos] = c;
          gps_buf_pos++;
          break;

        case 3:
          gps_buf[gps_buf_pos] = c;
          gps_buf_pos++;
          gps_buf[gps_buf_pos] = 0;

          parse (); // Complete telegram received
          state = 0;
          break;

        /* Should not be reached. */
        default:
          state = 0;
          break;
      }

      ca--;
    }

    /* }}} Done telegram handler */
  }

  void GPS::parse ()
  {
    /* GPS parser {{{
     *
     *
     */

    received++;

    GPS_TELEGRAM type = UNSPECIFIED;
    int  tokeni = 0;
    int  len = gps_buf_pos; // Excluding NULL terminator

    /*
    for (int i = 0; i < (len+1); i++)
      gps_data.lasttelegram[i] = gps_buf[i];
    */

    /* Test checksum before parsing */
    if (!test_checksum (gps_buf)) {
      return;
    }

    /* Update time, should be set in case time data has been received */
    bool doseconds = false;

    /* Parse */
    int i = 0;
    while (i < len)
    {
      /*
      uint32_t ltmp = 0;
      uint32_t remainder = 0;
      */

      char token[MAX_TELEGRAM_CHARS]; // Max length of token
      int j = 0;
      /* Get next token */
      while ((gps_buf[i] != ',' && gps_buf[i] != '*') && i < len) {
        token[j] = gps_buf[i];

        i++;
        j++;
      }
      i++; /* Skip delimiter */

      token[j] = 0;

      if (i < len) {
        if (tokeni == 0) {
          /* Determine telegram type */
          if (token[3] == 'R') type = GPRMC;

          /*
          else if (strcmp(token, "$GPGGA") == 0)
            type = GPGGA;
          else if (strcmp(token, "$GPGLL") == 0)
            type = GPGLL;
          else if (strcmp(token, "$GPGSA") == 0)
            type = GPGSA;
          else if (strcmp(token, "$GPGSV") == 0)
            type = GPGSV;
          else if (strcmp(token, "$GPVTG") == 0)
            type = GPVTG;
          */
          else {
            /* Cancel parsing */
            //type = UNKNOWN;
            return;
          }
          lasttype = type;

        } else {
          switch (type)
          {
            // GPRMC {{{
            case GPRMC:
              switch (tokeni)
              {
                case 1:
                  {
                    char t[4];
                    t[2] = 0;
                    t[3] = 0;
                    strncpy(t, token, 2);
                    hour   = strtol (t, NULL, 10);

                    strncpy(t, token+2, 2);
                    minute = strtol (t, NULL, 10);

                    strncpy(t, token+4, 2);
                    second = strtol (t, NULL, 10);

                    strncpy(t, token+7, 3); // skip delimiter
                    seconds_part = strtol (t, NULL, 10);

                    // Update seconds
                    doseconds = (day  > 0);
                  }
                  break;

                case 2:
                  valid = (token[0] == 'A');
                  break;

                case 3:
                  ref_position_lock = true;
                  strcpy (latitude, token);
                  break;

                case 4:
                  north =  (token[0] == 'N');
                  break;

                case 5:
                  strcpy (longitude, token);
                  break;

                case 6:
                  east = (token[0] == 'E');
                  ref_position_lock = false;
                  break;

                case 7:
                  //strcpy (speedoverground, token);
                  break;

                case 8:
                  //strcpy (courseoverground, token);
                  break;

                case 9:
                  {
                    char t[3];
                    t[2] = 0;

                    strncpy (t, token, 2);
                    day   = strtol (t, NULL, 10);

                    strncpy (t, token+2, 2);
                    month = strtol (t, NULL, 10);

                    strncpy (t, token+4, 2);
                    year = strtol (t, NULL, 10);

                    // Update if we got time
                    doseconds = (day > 0);
                  }
                  break;

                case 10: /* Magnetic declination not supported by device */

                default:
                  break;
              }
              break;
              // }}}

# if 0
            // GPGGA {{{
            case GPGGA:
              switch (tokeni)
              {
                case 1:
                  {
                    int r = sscanf (token, "%02d%02d%02d.%d", &(gps_data.hour), &(gps_data.minute), &(gps_data.second), &(gps_data.seconds_part));

                    // Update if we got all values
                    doseconds = (r == 4) && gps_data.day > 0;
                  }
                  break;

                case 2:
                  strcpy (gps_data.latitude, token);
                  break;

                case 3:
                  gps_data.north =  (token[0] == 'N');
                  break;

                case 4:
                  strcpy (gps_data.longitude, token);
                  break;

                case 5:
                  gps_data.east = (token[0] == 'E');
                  break;

                case 6:
                  /* 0 = Fix not valid
                   * 1 = GPS SPS mode, fix valid
                   * 2 = Differential GPS SPS mode, fix valid
                   * 3 = GPS PPS mode, fix valid
                   */
                  gps_data.valid = (token[0] >= '1');
                  gps_data.fixtype = (token[0] - '0');
                  break;

                case 7:
                  sscanf (token, "%d", &(gps_data.satellites));
                  break;
                case 8:  break; /* Discard HDOP */
                case 9:  break; /* Discard MSL altitude */
                case 10: break; /* Discard unit for ^^ */
                case 11: break; /* No support for Geoid separation */
                case 12: break; /* Discard unit for ^^ */
                case 13: break; /* Discard age of diff correction */
                case 14: break; /* Discard Diff. Ref. station ID */

                default:
                  break;

              }
              break;
            // }}}

            // GPGLL {{{
            case GPGLL:
              switch (tokeni)
              {
                case 1:
                  strcpy (gps_data.latitude, token);
                  break;

                case 2:
                  gps_data.north =  (token[0] == 'N');
                  break;

                case 3:
                  strcpy (gps_data.longitude, token);
                  break;

                case 4:
                  gps_data.east = (token[0] == 'E');
                  break;

                case 5:
                  {
                    int r = sscanf (token, "%02d%02d%02d.%d", &(gps_data.hour), &(gps_data.minute), &(gps_data.second), &(gps_data.seconds_part));
                    doseconds = (r == 4) && gps_data.day > 0;
                  }
                  break;

                case 6:
                  gps_data.valid = (token[0] == 'A');
                  break;

                default: break;
              }
              break;
            // }}}

            // GPGSA {{{
            case GPGSA:
              switch (tokeni)
              {
                case 1:
                  /* M = Manual forced to operate in 2D or 3D mode
                   * A = Automatic-allowed to automatically switch 2D/3D
                   */
                  gps_data.mode1 = (token[0] == 'M' ? 0 : 1);
                  break;

                case 2:
                  /* 0 => 1 = Fix not available
                   * 1 => 2 = 2D
                   * 2 => 3 = 3D
                   */
                  gps_data.mode2 = (token[0] - '1');
                  gps_data.valid = (token[0] > '1');
                  break;

                case 3:
                case 4:
                case 5:
                case 6:
                case 7:
                case 8:
                case 9:
                case 10:
                case 11:
                case 12:
                case 13:
                case 14:
                {
                  static int s = 0;
                  sscanf (token, "%d", &(gps_data.satellites_used[s]));
                  s++;

                  if (s >= 12) s = 0;
                }
                break;

                /* Discard:
                 * - PDOP
                 * - HDOP
                 * - VDOP
                 */
                default: break;
              }
              break;
            // }}}

            // GPGSV {{{
            case GPGSV:
            /* TODO: Handle multiple messages.. simply ignoring, could result
             * in wrong values for satellite count */
              {
                switch (tokeni)
                {
                  case 1:
                    break; /* Discard number of messages */

                  case 2:
                    break; /* Discard message number */

                  case 3:
                    sscanf (token, "%d", &(gps_data.satellites));

                  /* Discard the individual satellite data */

                  default:
                    break;
                }

              }
              break;
            // }}}
# endif

            default:
              /* Having reached here on an unknown or unspecified telegram
               * parsing is cancelled. */
              return;
          }
        }
      } else {
        /* Last token: Check sum */
      }
      tokeni++;
    }

    if (doseconds)
      update_second ();

    /* Done parser }}} */
  }

# if DEBUG_VERB
  void GPS::print_status () { // {{{
    SerialUSB.print ("[GPS] lat: ");
    SerialUSB.print (latitude);
    SerialUSB.print (", lon: ");
    SerialUSB.print (longitude);
    SerialUSB.print (", time: ");
    SerialUSB.print (time);
    SerialUSB.print (", date: ");
    SerialUSB.print (day);
    SerialUSB.print (month);
    SerialUSB.println (year);
  } // }}}
# endif

  void GPS::enable_sync () {
    /* Miller, S. et. al.: http://www.nmt.edu/~sfs/Students/ScottMiller/Papers/EMCW_paper.pdf
     *
     * says PPS should be timed from the rising edge, might be device
     * dependant. we are currently measuring falling.
     *
     * RFC2783 documents for the Linux kernel to use a configurable edge
     * detection, not mentioning a standard output format, it apparently
     * can be either or both.
     *
     */

    attachInterrupt (GPS_SYNC_PIN, &(GPS::sync_pulse_int), FALLING);
  }
  void GPS::disable_sync () {
    detachInterrupt (GPS_SYNC_PIN);
  }
}

/* vim: set filetype=arduino :  */
