gauteh/sonobuoy/zero/index.py

# -*- coding: utf-8 -*-
# Author: Gaute Hope <eg@gaute.vetsj.com> / 2012-05-14
#
# index.py: Keep track of indexes for buoy

import threading
import logging
import time
import os

from data import *

class Index:
  buoy      = None
  logger    = None
  protocol  = None

  indexf_uri  = None
  indexf      = None

  idle        = False # all data received, all up to date
  cleanup     = False # indicate to buoy that it should send no more requests
  action      = None  # Event indicating that something has happened and the
                      # loop should iterate

  data        = None
  greatestid  = 0
  lastid      = 0
  __id_check_done__             = False
  __full_data_check_done__      = False

  # id for log
  me = ""

  # goal radiorate, try to achieve this radiorate (only for data transfer)
  # range: 0 - 3
  goal_radiorate = 0

  def __init__ (self, l, _buoy):
    self.data = []
    self.logger = l
    self.buoy = _buoy
    self.protocol = self.buoy.protocol
    self.me = "[" + self.buoy.name + "] [Index]"
    self.indexf_uri = os.path.join (self.buoy.logdir, 'indexes')
    self.action = threading.Event ()

    self.logger.info (self.me + " Initializing and opening index..: " + self.indexf_uri)
    self.open_index ()

  def event (self, caller):
    #self.logger.debug (self.me +  " Set action: " + caller)
    self.action.set ()

  def complete (self):
    return ( self.__full_data_check_done__ and
             self.__id_check_done__ or
             not self.buoy.getdata)

  # return percent complete
  def completeness (self):
    pass

  ''' Open index list file and read known data segments and status {{{

      Index file format, text, one line per data segment (as returned by GETIDS):
      id,enabled
  '''
  def open_index (self):
    if os.path.exists (self.indexf_uri):
      self.indexf = open (self.indexf_uri, 'r')
      for l in self.indexf.readlines ():
        s = l.split (",")
        e = (s[1].strip () == "True")
        self.data.append (Data (self.logger, self.buoy, self, int(s[0]), e))

        if int(s[0]) > self.greatestid:
          self.greatestid = int(s[0])

      self.indexf.close ()

    self.data.sort (key = lambda d: d.id)

  ''' Write out all known indexes '''
  def write_index (self):
    self.indexf = open (self.indexf_uri, 'w+') # truncate file
    self.data.sort (key = lambda d: d.id)
    for i in self.data:
      self.indexf.write (str(i.id) + "," + str(i.enabled) + '\n')

    self.indexf.close ()
  # }}}

  def close (self):
    for i in self.data:
      i.close ()

    self.write_index ()

  def fastradiorate (self):
    # try to set goal radiorate for data transfer
    # be a little more clever, keeping it down if we dont get a signal
    if self.buoy.radiorate != self.goal_radiorate:
      self.logger.info (self.me + " Setting buoy radio rate to goal: " + str(self.goal_radiorate))
      self.protocol.znbuoyradiorate (self.goal_radiorate)

    #self.event ("fastradiorate")

  def checkradiorate (self):
    if self.buoy.radiorate != 0:
      if (time.time () - self.buoy.set_radiorate_t) > self.buoy.RADIORATE_TIMEOUT:
        self.logger.info (self.me + " Buoy radio rate timed out, resetting rate.")
        self.buoy.radiorate = 0


  # GETIDS: Depreceated {{{
  gotids_n = 0
  def getids (self, start):
    ''' Update local list of ids from buoy, working backwards '''
    if self.state == 0:
      self.fastradiorate ()
      self.protocol.send ("GIDS," + str(start))
      self.request_t = time.time ()
      self.timeout   = self.getids_timeout
      self.gotids_n = 0
      self.state    = 1

  def gotids (self, id, enabled):
    self.gotids_n = self.gotids_n + 1

    # check if id is in special check list
    if self.__unchecked_ids__ is not None:
      if id in self.__unchecked_ids__:
        self.__unchecked_ids__.remove (id)
        self.logger.debug (self.me + " Got missing id: " + str(id) + ", remaining: " + str(self.__unchecked_ids__))

    if id <= self.lastid:

      if id == self.lastid:
        enabled = 1

      if enabled == 1:
        enabled = True
      else:
        enabled = False

      if self.greatestid < id:
        self.greatestid = id
        self.__full_data_check_done__ = False
        self.__incremental_id_check_done__ = False

      if self.indexofdata(id) is None:
        self.logger.info (self.me +  " Got id: " + str(id))
        self.data.append (Data (self.logger, self.buoy, self, id, enabled))
      else:
        self.logger.info (self.me + " Got already known id: " + str(id))

      self.write_index ()

    if self.gotids_n >= 10:
      if self.pendingid == 3:
        self.state = 0
  # }}}

  def indexofdata (self, id):
    n = 0
    for i in self.data:
      if i.id == id:
        return n
      n = n + 1

    return None

  def check_and_add_ids (self):
    # We're just adding the ids, if they turn out empty we will have figured it
    # out as we try to get the full index
    if self.lastid > 0:
      if not self.__id_check_done__:
        for i in range (1, self.lastid + 1):
          if self.indexofdata(i) is None:
            self.logger.info (self.me + " Adding id: " + str(i))
            self.data.append (Data (self.logger, self.buoy, self, i, True))
      else:
        # just check from greatest id
        for i in range(self.greatestid, self.lastid + 1):
          if self.indexofdata(i) is None:
            self.logger.info (self.me + " Adding id: " + str(i))
            self.data.append (Data (self.logger, self.buoy, self, i, True))

    self.greatestid = self.lastid
    self.__id_check_done__ = True
    self.__full_data_check_done__ = False
    self.event ("check_and_add_ids")

  def getlastid (self):
    if self.state == 0:
      self.request_t = time.time ()
      self.timeout   = self.sync_lastid_timeout
      self.state = 1
      self.protocol.send ("GLID")

  def gotlastid (self, id):
    if id != self.lastid:
      self.__id_check_done__        = False
      self.__full_data_check_done__ = False

    self.lastid = id
    self.logger.info (self.me + " Latest id: " + str(self.lastid))
    self.buoy.log ("[Buoy] Latest id: " + str(self.lastid))
    self.sync_lastid_t = time.time ()
    if self.pendingid == 2:
      self.state = 0

    # Check if there are any missing ids initialized
    self.event ("gotlastid")

  def getid (self, id):
    if self.state == 0:
      self.logger.info (self.me + " Getting full index for: " + str(id))
      self.pendingid = 4
      self.state     = 1
      self.timeout   = self.getid_timeout

      self.protocol.send ("GID," + str(id))

      self.request_t = time.time ()

  # should probably be gotind..
  def gotid (self, id, store_version, samples, n_refs, e_sdlag):
    self.logger.info (self.me + " Got full index: " + str(id) + ", samples: " + str(samples) + ", no of refs: " + str(n_refs) + " (store version: " + str(store_version) + ") (sdlag: " + str(e_sdlag) + ")")
    if self.working_data is not None:
      if self.working_data.id == id:
        self.working_data.fullindex (samples, n_refs, store_version, e_sdlag)

    if self.pendingid == 4:
      self.state = 0

    self.event ("gotid")

  requested_chunks = 0
  def getbatch (self, id, ref, start, length):
    if self.state == 0:
      self.fastradiorate ()
      self.logger.info (self.me + "[" + str(id) + "] Req chunk, ref: " + str(ref) + ", start: " + str(start) + ", length: " + str(length))
      self.pendingid = 5
      self.state     = 1
      self.requested_chunks = (length / CHUNK_SIZE) + (1 if (length % CHUNK_SIZE > 0) else 0)

      self.protocol.send ("GB," + str(id) + "," + str(ref) + "," + str(start) + "," + str(length))

      self.request_t = time.time ()
      self.timeout   = self.getbatch_timeout

  def gotbatch (self, id, refno, start, length, ref, refstat, latitude, longitude, checksum, samples):
    self.logger.debug (self.me + " Got batch, id: " + str(id) + ", ref no: " + str(refno) + ", start: " + str(start) + ", length: " + str(length))
    if self.working_data is not None and self.working_data.id == id:
      self.working_data.got_chunk (refno, start, length, ref, refstat, latitude, longitude, checksum, samples)

    if self.pendingid == 5:
      self.requested_chunks -= 1
      if self.requested_chunks <= 0:
        self.state = 0
        self.event ("gotbatch all")

  status = 0
  def getstatus (self):
    if self.state == 0:
      self.request_t = time.time ()
      self.timeout = self.sync_status_timeout
      self.status = 0
      self.state = 1
      self.protocol.send ("GS")
      self.pendingid = 1

  def gotstatus (self):
    if self.status == 0: # got gps status
      self.status = 1 # wait for ad status
    elif self.status == 1:
      if self.pendingid == 1:
        self.state  = 0
      self.status = 0
      self.sync_status_t = time.time ()
      if self.buoy.remote_protocolversion > 1:
        self.logger.debug (self.me + " Status updated, uptime: " + str(self.buoy.uptime / 1000) + " s")
        self.buoy.log ("[Buoy] Uptime: " + str(self.buoy.uptime / 1000) + "s")
      else:
        self.logger.debug (self.me + " Status updated.")
      self.event ("gotstatus")


  def getinfo (self):
    if self.state == 0:
      self.request_t  = time.time ()
      self.timeout    = self.getinfo_timeout
      self.state      = 1
      self.protocol.send ("GIF")
      self.pendingid  = 6

  def gotinfo (self, bid, version, protocolversion, storeversion):
    if bid != self.buoy.id:
      self.logger.error (self.me + " Got info message for another buoy. Discarding.")
      return

    self.buoy.remote_version = version
    self.buoy.remote_protocolversion = protocolversion
    self.buoy.remote_storeversion = storeversion

    self.logger.info (self.me + " [Info] Remote version: " + version + ", protocol version: " + str(protocolversion) + ", store version: " + str(storeversion))
    self.buoy.log ("[Info] Remote version: " + version + ", protocol version: " + str(protocolversion) + ", store version: " + str(storeversion))

    self.has_info   = True
    self.state      = 0
    self.pendingid  = 0

    self.event ("gotinfo")

  # State for keeping this buoys data uptodate
  state     = 0
  timeout   = 0  # seconds, should be set relevant to appropriate request
  pendingid = 0  # automatic request last sent (in case manual request mess up the flooooow..)
  request_t = 0

  sync_lastid   = 1 * 60 # time between syncs of last id
  sync_lastid_t = 0
  sync_lastid_timeout = 10

  sync_status   = 20 # time between status updates
  sync_status_t = 0
  sync_status_timeout = 10

  has_info          = False # only get info once
  getinfo_timeout   = 10

  getid_timeout     = 10
  getids_timeout    = 15
  getbatch_timeout  = 10

  default_chunks    = 10 # number of chunks/batches to request in one go

  working_data  = None   # working data object, getting full index, refs and data

  # For developers reference when implementing new telegrams
  # Latest used pending id: 6

  def loop (self):
    # Check if radiorate has been reset
    self.checkradiorate ()

    if self.buoy.zero.ser is not None and self.buoy.zero.acquire:
      if self.state == 0 and not self.cleanup:
        # Get status and lastid {{{
        if not self.has_info:
          self.getinfo ()
          return

        if time.time () - self.sync_status_t > self.sync_status:
          self.pendingid = 1
          self.getstatus ()
          return

        if time.time() - self.sync_lastid_t > self.sync_lastid:
          self.pendingid = 2
          self.getlastid ()
          return
        # }}}

        if self.buoy.getdata:
          # check if we have all ids
          if not self.__id_check_done__:
            self.check_and_add_ids ()

          # download data, strategy:
          #
          # start on last id, get full id then start to get batches and chunks
          # from beginning of corresponding data file to id.

          # get data {{{
          if self.working_data is not None:

            if not self.working_data.hasfull:
              # get full index
              self.getid (self.working_data.id)
              return

            elif not self.working_data.hasalldata:
              # continue to get refs on this id
              # figure out which refs are missing
              ii = 0
              while ii < self.working_data.refs_no:
                i = self.working_data.indexofbatch (ii)
                if i is None:
                  # start on new batch
                  # found missing chunks, figure out how many of the
                  # following are missing for inclusion in this request.
                  kk = ii + 1
                  while kk < self.working_data.refs_no and self.working_data.indexofbatch(kk) is None:
                    kk = kk + 1

                  chunks_to_get = min ((kk - ii) * Batch.maxchunks, self.default_chunks)

                  self.getbatch (self.working_data.id, ii, 0, chunks_to_get * CHUNK_SIZE)
                  return
                else:
                  # check if this batch has been completed
                  i = self.working_data.batches[i]
                  if not i.complete:
                    # get rest of this batch, figure out which next chunk is missing
                    jj = 0
                    while jj < i.maxchunks:
                      if not jj in i.completechunks:
                        # found missing chunks, figure out how many of the
                        # following are missing for inclusion in this request.
                        kk = jj + 1 # on this batch
                        while kk < i.maxchunks and kk not in i.completechunks:
                          kk = kk + 1

                        chunks_to_get = kk - jj

                        # on following empty batches
                        kk = ii + 1
                        while kk < self.working_data.refs_no and self.working_data.indexofbatch(kk) is None:
                          kk = kk + 1

                        chunks_to_get += (kk - ii) * Batch.maxchunks

                        chunks_to_get = min (chunks_to_get, self.default_chunks)
                        self.getbatch (self.working_data.id, ii, CHUNK_SIZE * jj, chunks_to_get * CHUNK_SIZE)
                        return
                      jj = jj + 1

                    # all chunks done on this batch

                ii = ii + 1

              # all batches done
              self.logger.info (self.me + " Finished id: " + str(self.working_data.id))
              self.working_data.hasalldata = True
              self.working_data.write_index ()
              self.working_data = None

            else:
              self.logger.info (self.me + " Finished id: " + str(self.working_data.id))
              self.working_data.hasalldata = True
              self.working_data.write_index ()
              self.working_data = None

          elif self.lastid > 0 and self.greatestid == self.lastid and not self.__full_data_check_done__:
            # find latest id with missing index, refs or data
            ii = self.lastid - 1

            while ii > 0:
              d  = None
              di = self.indexofdata (ii)
              if di is not None:
                d = self.data[di]

              if d is not None:
                if d.enabled and not (d.hasfull and d.hasalldata):
                  self.working_data = d
                  self.logger.info (self.me + " Working on id: " + str(d.id))
                  return
                else:
                  ii = ii - 1

            # none missing found
            self.working_data = None
            self.__full_data_check_done__ = True
            self.logger.info (self.me + " All data up to date.")
            return

          # Everything is happy dandy.. I'm idle.
          else:
            if not self.idle_msg:
              self.logger.info (self.me + " Idle.")
              self.idle_msg = True

            self.idle = True
            return
          # }}}

        else:
          if not self.idle_msg:
            self.logger.info (self.me + " Idle (data acquisition disabled).")
            self.idle_msg = True
          self.idle = True


      elif self.state == 0 and self.cleanup:
        self.logger.info (self.me + " Cleaned up. Idle.")
        self.idle = True

      if self.state == 0 and self.idle:
        self.event ("idle")

      # waiting for response
      elif self.state == 1:
        # time.time out
        if time.time () - self.request_t > self.timeout:
          self.logger.debug (self.me + " Request timed out, reset..")
          self.reset (timeout = True)

        else:
          #self.logger.debug (self.me + " Clear action.")
          self.action.clear ()

  reseti = 0 # times tried to reset
  def reset (self, keepradiorate = False, timeout = False):
    self.reseti += 1

    self.logger.debug (self.me + " Resetting communication state (try: " + str(self.reseti) + ").")

    # reset in case checksum mismatch or timeout
    if self.pendingid == 5 and self.requested_chunks > 1 and not timeout:
      # in case there was a failure on one batch the rest will still
      # be coming these should not be re-requested yet.
      self.requested_chunks -= 1

    elif self.pendingid == 3 and self.gotids_n < 10 and not timeout:
      self.gotids_n += 1

    else:
      self.state    = 0
      self.gotids_n = 0
      self.status   = 0
      self.pendingids = 0
      self.requested_chunks = 0

    if not keepradiorate:
      if ((time.time () - self.buoy.set_radiorate_t) > self.buoy.RADIORATE_TIMEOUT) or (self.protocol.radiorate_confirmed == False):
        self.buoy.radiorate = 0

    """
    elif (self.reseti % 2 == 0):
      if self.buoy.radiorate == 0:
        self.fastradiorate ()
      else:
        self.buoy.radiorate = 0

      self.logger.debug (self.me + " Reset: Trying to swap to radiorate: " + str(self.buoy.radiorate))
    """

    # reset protocol
    self.protocol.a_receive_state = 0
    self.protocol.a_buf = ''
    self.protocol.waitforreceipt = False

    self.event ("reset")
