gauteh/sonobuoy/buoy/types.h

/* Author:  Gaute Hope <eg@gaute.vetsj.com>
 * Date:    2012-02-05
 *
 * Forward declarations of all classes.
 *
 */

# pragma once

namespace Buoy {
  class BuoyMaster;
  class RF;
  class GPS;
  class ADS1282;
  class Store;
}
