gauteh/sonobuoy/buoy/linx_rxm_gps.c

/* Author:  Gaute Hope <eg@gaute.vetsj.com>
 * Date:    2011-09-05
 *
 * Interface to the LINX RXM GPS over UART.
 *
 *
 */

# ifndef LINXGPS
# define LINXGPS

# include "buoy.h"

# define GPS_BUF_LEN  1024
# define TELEGRAM_LEN 80

char gps_buf[TELEGRAM_LEN + 2];
int  gps_buf_pos   = 0;

char gps_rmc[TELEGRAM_LEN];


void gps_setup ()
{
  Serial.println ("[GPS] Setting up GPS serial interface (Serial1)..");
  Serial1.begin (9600);

  gps_buf[0] = 0;
  gps_rmc[0] = 0;
}

void gps_loop ()
{
  int ca = Serial1.available (); 

  while (ca > 0) {
    int c = Serial1.read ();

    if (c == '\r' || c == '\n')
      continue;

    if (((char)c) == '$') {
      gps_buf[gps_buf_pos] = 0;
      for (int i = 0; i < gps_buf_pos; i++)
      {
        strcpy (gps_rmc, gps_buf);
        gps_rmc[gps_buf_pos] = 0;
      }
      gps_buf_pos = 0;
    }

    gps_buf[gps_buf_pos] = (char)c;
    gps_buf_pos++;
    ca--;
  }
}

void gps_status (HardwareSerial s)
{
  s.print ("[GPS] ");
  int i = 1;
  do {
    s.print (gps_rmc[i]);
    i++;
  } while (gps_rmc[i] != 0 && i < TELEGRAM_LEN);

  s.println ("$");
}

# endif

/* vim: set filetype=arduino :  */
