gauteh/sonobuoy/zero/buoys.py

# -*- coding: utf-8 -*-
# Author: Gaute Hope <eg@gaute.vetsj.com> / 2012-04-10
#
# Defines buoys with addresses and settings.
#

buoys = [ { 'id' :        1,
            'name' :      'One',
            'address' :   '04:3C:60',
            'enabled' :   False,
            'getdata' :   True,
          },

          { 'id' :        2,
            'name' :      'Two',
            'address' :   '00:00:FF',
            'enabled' :   False,
            'getdata' :   True,
          },

          { 'id' :        3,
            'name' :      'Three',
            'address' :   '04:3C:64',
            'enabled' :   False,
            'getdata' :   False,
          },

          { 'id' :        4,
            'name' :      'Four',
            'address' :   '04:3C:93',
            'enabled' :   True,
            'getdata' :   False,
          },

          { 'id' :        5,
            'name' :      'Five',
            'address' :   '03:FF:40',
            'enabled' :   False,
            'getdata' :   True,
          },
        ]
