gauteh/sonobuoy/(commit log)

2011-09-03 comments and 1khz sample rate
2011-09-04 AD7710: Monitoring DRDY for interrupts and sampling as data gets ready, about 1032 Hz max
2011-09-04 Move all AD to driver
2011-09-08 BROKEN: store lots of values..
    [ad7710.c]
2011-09-09 move prototypes to header
2011-09-13 WIP: Send binary samples
2011-09-15 Successfully sending 20 samples in binary
2011-09-19 WIP: 24 bit sample type
2011-09-19 3 byte samples stored and transmitted
2011-09-19 Send 35 samples
2011-09-19 transmitting at about 100 hz
2011-09-28 lock on swap store, store tuples, and discard data
    [ad.py, buoy.py, zero.py]
2011-10-05 GPS: Prepare for interrupt
2011-10-05 Correctly calculate unix time
    [gps.pde, rf.pde]
2011-10-06 Enable Software SPI on SD
2011-10-15 Revert "WIP: sd card.."
    This reverts commit 8ab7604bd76af7b85c91399144a6e13924133c1d.
    [store.pde]
2011-10-15 Close file correct place
    [store.pde]
2011-10-15 don't print processing
2011-10-16 correctly restart serial link
    [zero.py]
2011-10-19 reading samples
2011-10-19 200 hz sampling
2011-10-19 fix queue reading error
    [store.pde]
2011-10-25 shit decoupling schematics
    [Arduino_MEGA2560_ref.brd, Arduino_MEGA2560_ref.sch, decoupling.sch, shift_decoupling.sch, suggested_decoupling.sch]
2011-10-26 vref decoupling
    [shift_decoupling.sch]
2011-10-26 schema vref shift decouple
    [shift_decoupling_vref.sch]
2011-10-26 use vref
    [shift_decoupling_vref.sch]
2011-11-01 clean rf200 and coupling
    [decoupling_opamp.sch, shift_decoupling.sch]
2011-12-24 new paths for arduino 1.0
2011-12-24 arduino 100
2012-01-17 clean out arduino based code
2012-01-17 initial libmaple skeleton
    [flash_0.3.cfg, flash_0.4.cfg]
2012-01-18 proper LDFLAGS for arm g++
2012-01-18 don't print individual sizes
2012-01-18 WIP: SPI
2012-01-18 getting ready for i2c
2012-01-23 static hardware spi
2012-01-23 i2c alive
2012-01-25 gettin ready with spi impl.
2012-01-26 correct shiftout and in
    [ads1282.cpp, ads1282.h]
2012-01-26 correct clocking of registers
    [ads1282.cpp]
2012-01-27 string rep of spi commands
2012-01-27 10000 samples
2012-01-30 appearantly reading data correctly in bipolar mode
    [ads1282.cpp, ads1282.h]
2012-01-31 correct configuration and correct reading
    [ads1282.cpp, ads1282.h]
2012-01-31 sample on drdy
2012-01-31 cleanup hw
    [Arduino_MEGA2560_ref.brd, Arduino_MEGA2560_ref.sch, decoupling_opamp.sch, decoupling_rail_splitter.sch, decoupling_resistor_divider.sch, shift_decoupling.sch, shift_decoupling_vref.sch, suggested_decoupling.sch]
2012-01-31 configure HFP filter
2012-02-01 transferring samples over rf
2012-02-02 correctly calculate sample rate
    [ad.py, ui.py]
2012-02-05 sd spi pins
2012-02-11 Correct freq, and enable
    [buoy.cpp, store.cpp]
2012-02-16 follow batches up to current
2012-02-17 WIP: fix gps sync
    [ads1282.cpp, ads1282.h, buoy.h, gps.cpp, gps.h, rf.cpp, store.cpp]
2012-02-20 correctly calc unix time
    [gps.cpp]
2012-02-23 schema + parts for power and preamp
    [power.sch, preamp.sch]
2012-02-23 low pass preamp
    [power.sch, preamp.sch]
2012-02-23 high pass at 0.5 hz
2012-02-24 power budget and pin map
    [Pin map and configuration.ods, PowerBudget.ods]
2012-02-24 update pin map
    [Pin map and configuration.ods]
2012-02-24 12v power+preamp
    [PowerBudget.ods, power_12v.sch, power_24v.sch, preamp_12v.sch, preamp_24v.sch]
2012-02-25 avoid -5V linear vr
    [Pin map and configuration.ods, power_12v.sch, preamp_12v.sch]
2012-02-25 move 24v to alternative
    [power_24v.sch, preamp_24v.sch]
2012-02-26 name and attribution on schemas, plot mb=2 at 50km
    [power_12v.sch, preamp_12v.sch]
2012-02-26 parts list 12v supply
    [power_12v.sch]
2012-02-28 WIP: bandstop dft filter
2012-03-01 break out reset pin
    [Pin map and configuration.ods]
2012-03-05 correctly label of ads pin
    [Pin map and configuration.ods]
2012-03-05 fix title
    [Pin map and configuration.ods]
2012-03-06 don't print all file names checked
2012-03-06 AD: Increase delay after sending RDATAC, might fix cold-start issues
    [ads1282.cpp]
2012-03-06 Clean up main.cpp and buoy.cpp, fix LASTID.LON issues in store.cpp
    [buoy.h, main.cpp, store.cpp]
2012-03-07 stop continous on error
    [ads1282.cpp]
2012-03-12 working simple ideal bandpass filter
2012-03-20 stop when C-c when serial, print correct summary
    [buoy.py, zero.py]
2012-03-20 save samples per reference in index
2012-03-21 write new array type correctly, log exceptions correctly
    [buoy.py, zero.py]
2012-03-21 A small delay (printing to usb) seems to make re-activate sd card work
2012-03-21 Read samples_per_ref.. as well
2012-03-21 Switch batch at correct position
    [ads1282.cpp]
2012-03-22 go back to 10000 q-length, dont print each ref
2012-03-30 olimex pin map
    [Olimexino - pin map.ods, Pin map and configuration.ods]
2012-03-30 friendlier names
    [MapleNativeBeta - pin map and configuration.ods, Olimexino - pin map and configuration.ods, Olimexino - pin map.ods, Pin map and configuration.ods, Power budget.ods]
2012-03-30 onboard sdheader
    [Olimexino - pin map and configuration.ods]
2012-04-01 replace empty files when rolling
    [buoy.py]
2012-04-01 fix typo in log message
    [protocol.py]
2012-04-02 convert to unix ff, fix ad_k_samples=0 bug
    [protocol.py]
2012-04-03 avoid scanf in gps.cpp
    [gps.cpp]
2012-04-03 avoid sscanf in rf.cpp
    [gps.cpp, rf.cpp]
2012-04-05 self made, un-safe strcmp and strcpy, avoid strlen
    [ads1282.cpp, buoy.cpp, buoy.h, rf.cpp, rf.h]
2012-04-05 Swap buf in itoa
    [buoy.cpp, store.cpp]
2012-04-05 document protocol
    [Protocol.ods]
2012-04-06 prepare snaps to crossconnect
    [buoy.cpp, buoy.h, buoy.py, rf.cpp, zero.py]
2012-04-08 untested: zeronode, handle address commands, and relay buoy commands
2012-04-10 fix incorrect return message identifier for GETSTATUS
    [Protocol.ods]
2012-04-18 extend hardware parts list
    [Parts.ods]
2012-04-21 started wiring olimexino + new power circuit
    [Power budget, rev2.ods, Power budget.ods]
2012-04-21 default olimex, check for support board
2012-04-21 only ads1282, gettin ready for olimexino
    [Olimexino - pin map and configuration.ods, Power budget, rev2.ods]
2012-04-22 update parts list
    [Parts.ods]
2012-04-27 ten-5, setup ads1282 w/ olimex
    [Olimexino - pin map and configuration.ods, Parts.ods, Power budget, rev2.ods]
2012-04-27 testing i2c
2012-04-28 twiggle pins
    [Olimexino - pin map and configuration.ods]
2012-04-28 dont print exeption
2012-04-28 local board specifics
2012-05-05 up hw conf
    [Olimexino - pin map and configuration.ods]
2012-05-05 vol range
    [Olimexino - pin map and configuration.ods]
2012-05-05 olimex: use inital pins, conflicting with leds
2012-05-06 rm obsolete shift comment problem
    [ads1282.cpp]
2012-05-07 use dgnd, less outputs on U7
    [Olimexino - pin map and configuration.ods]
2012-05-07 working ads1282
    [Olimexino - pin map and configuration.ods, Power budget, rev2.ods]
2012-05-07 sd card power
    [Power budget, rev2.ods]
2012-05-07 sd_cs is 25
    [Olimexino - pin map and configuration.ods, Power budget, rev2.ods]
2012-05-08 set all ports to input on u7, reduces dvdd to ~6mA, summarize size in Makefile
2012-05-08 upd power -40 mA
    [Power budget, rev2.ods]
2012-05-08 comment on confusing ads reset
    [ads1282.cpp]
2012-05-10 gps pin map
    [Olimexino - pin map and configuration.ods]
2012-05-10 added and enabled gps
    [Power budget, rev2.ods]
2012-05-10 correctly parse time and date with gps
    [gps.cpp]
2012-05-10 sep status functions, fix date parsing in gps
    [ads1282.cpp, ads1282.h, buoy.cpp, gps.cpp, gps.h, store.cpp]
2012-05-10 rf: working
    [Power budget, rev2.ods]
2012-05-10 ready for preamp
    [Power budget, rev2.ods]
2012-05-10 use fixed batchlength for sample rate calculation on zero
    [ad.py, ui.py]
2012-05-11 probs with random crash on rf, sending list of ids work
    [buoy.py, gps.cpp, protocol.py, rf.cpp, store.h, ui.py, ztool.py]
2012-05-11 power for preamp+hyd
    [Power budget, rev2.ods]
2012-05-11 missing arg for getids command
    [Protocol.ods]
2012-05-14 WIP: automatic data retrieval
    [Protocol.ods]
2012-05-14 openocd 0.5 and conf for arm-usb-ocd-h olimex debugger
    [flash_0.5.cfg]
2012-05-14 elaborate on protocol
    [Protocol.ods]
2012-05-14 correctly read enabled status on data segment
    [data.py, index.py]
2012-05-15 return on fail in protocol
    [protocol.py]
2012-05-15 Reset over-air by RF200
    [Olimexino - pin map and configuration.ods, Protocol.ods]
2012-05-15 wip: no data collect, rf works
    [Olimexino - pin map and configuration.ods]
2012-05-15 check for missing ids on new lastid
    [index.py]
2012-05-15 power on full op on rf
    [Power budget, rev2.ods]
2012-05-16 reset also working over usb and button
    [ads1282.cpp, buoy.cpp, buoy.h, buoy.py, rf.cpp, rf.h]
2012-05-16 pin 7 is nDRDY
    [Olimexino - pin map and configuration.ods]
2012-05-16 make sure manual requests doesn't mess up state of automatic requests
    [buoy.py, index.py]
2012-05-16 update olimex board config
2012-05-16 gps: use serial3 and pin 2 for interrupt
2012-05-16 Fix badass race: Increase priority on usart interrupt
2012-05-16 Remap pins
    [Olimexino - pin map and configuration.ods]
2012-05-17 only send necessary IND stuff
    [Protocol.ods]
2012-05-17 WIP: dont get refs, get batches
    [Protocol.ods]
2012-05-18 WIP: getbatch
    [Protocol.ods]
2012-05-19 cleanup check_index and add reset_index
    [store.cpp, store.h]
2012-05-19 fix some issues on got_chunks
    [data.py, protocol.py, rf.h]
2012-05-20 handle error while transmitting samples
    [index.py, store.cpp]
2012-05-20 correct transmit data files
    [data.py]
2012-05-20 correctly clock out error'ed batch
    [store.cpp]
2012-05-20 update docs, BADDTT -> BADDAT
    [Protocol.ods]
2012-05-20 pendingid on getstatus
    [Protocol.ods]
2012-05-23 print timestamp every min
2012-05-24 allow sample == 0
2012-05-24 max channel tx, less output, fix hasfull status on data file
    [ad.py, buoy.py, data.py, index.py]
2012-05-24 check for out of sync / sd lag
    [Protocol.ods]
2012-05-26 add size budget, upd ref size in store.h
    [Size budget.ods]
2012-05-26 rn power budget in hardware, create power budget in doc
    [Power budget.ods, Power measurements, rev2.ods, Power measurements.ods]
2012-05-26 extend explanation of fields on protocol
    [Protocol.ods]
2012-05-26 instrument response
    [Hydrophone_decoupling.sch]
2012-05-28 upd response doc
    [Hydrophone_decoupling.sch]
2012-05-28 add opamp
    [Hydrophone_decoupling.sch]
2012-05-29 upd current usage on opa633
2012-06-12 gps -> serial2, better hasrf/hasgps defines
    [Olimexino - pin map and configuration.ods]
2012-06-12 miswired ads1282 din/dout, swapped in code..
    [Olimexino - pin map and configuration.ods]
2012-06-14 matlab: conversion to voltage and pressure
2012-06-18 rename size budget to data capacity budget
    [Local data capacity budget.ods, Size budget.ods]
2012-06-19 gps wiring
    [Olimexino - pin map and configuration.ods]
2012-06-20 print __LINE__ on ad error
    [ads1282.cpp, ads1282.h]
2012-06-20 avoid usage of pca9535
    [ads1282.cpp, ads1282.h]
2012-06-20 fix out-of-count with data rx, threw away non-existent old ref when expecting to start on not a fresh batch
    [data.py]
2012-06-20 no need for Wire
2012-06-22 Include GPS position in reference.
    [Protocol.ods]
2012-06-23 add individual gps track and log files for buoys
2012-06-23 log buoy errors on individual log file
    [protocol.py]
2012-06-25 fix b 3 error, look for next in-complete buoy
    [buoys.py, index.py, zero.py]
2012-06-25 decrease time delay in current buoy loop
2012-06-26 matlab: first attempt at plotting traces
2012-06-28 prep buoy for sending mulitple batches, better current buoy loop, fix no arg for ztool case
    [buoys.py, index.py, rf.cpp, rf.h, store.cpp, store.h, zero.py, ztool.py]
2012-06-28 bad prototype
2012-06-29 add text
    [preamp_12v.sch]
2012-06-29 correct length of batches and references
    [main.cpp, store.h]
2012-06-29 protocol: accept checksum token
    [Protocol.ods]
2012-07-01 fix noise range, handle corrupt ITT file
    [data.py]
2012-07-02 upd data capacity budget, clean up
    [Local data capacity budget.ods]
2012-07-02 upd DTT format to include 0 on position, matlab: plot track on map
2012-07-02 fix various iterate buoy issues
    [buoys.py, index.py, zero.py]
2012-07-02 add check for test_checksum, fix ref store in indexes (dtt)
    [buoy.cpp, buoys.py, data.py, zero.py]
2012-07-02 plot track working
2012-07-04 reset radiorate timer if approaching reset to def
    [protocol.py]
2012-07-04 fix read of itt, all data deleted
    [data.py]
2012-07-04 dont reset radiorate unless its necessary
    [index.py, protocol.py]
2012-07-30 correct format for buoy log
    [buoy.py]
2012-07-31 dont reset on existing chunks
    [data.py]
2012-07-31 toggle radiorate during reset to check if we're out of sync, cleanup comments
    [data.py, index.py, zero.py]
2012-07-31 matlab gui for monitoring trace
2012-08-01 revert to radiorate 1
    [index.py]
2012-08-01 dont print so much
2012-08-02 index: comment out radiorate toggeling on reset
    [index.py]
2012-08-02 more comments on data capacity budget
    [Local data capacity budget.ods]
2012-08-02 update protocol documentation
    [Protocol.ods]
2012-08-05 protocol: don't reset radiorate on buoy error
    [index.py, protocol.py]
2012-08-05 protocol: only reset index in case of command error
    [protocol.py]
2012-08-05 protocol: dont reset radiorate on protocol errors
    [protocol.py]
2012-08-05 index: don't reset state if only part of request fails
    [index.py]
2012-08-06 rf: send buoy id along with error
    [rf.cpp]
2012-08-06 add maxidreached error
    [Protocol.ods]
2012-08-06 rf, buoy: add protocol version, add buoy info telegram
    [Protocol.ods]
2012-08-06 handle uptime and getinfo messages
    [Protocol.ods]
2012-08-06 version note on gps telegram
    [Protocol.ods]
2012-08-06 store: fix E_SDLAG bug: dont write index before finished file, move roll data check to after write_batch and write_reference
    [store.cpp]
2012-08-06 protocol: handle version 2 errors
    [protocol.py]
2012-08-06 rename power measurements
    [Power measurements, MapleNativeBeta.ods, Power measurements, Olimexino.ods]
2012-08-06 reset pin
    [Olimexino - pin map and configuration.ods]
2012-08-06 reload in case data file is incomplete
2012-08-07 buoy: def version unknown, fix err log on old protocol version
    [buoy.py, protocol.py]
2012-08-07 p: better handle error id stuff
    [protocol.py]
2012-08-08 hw: start on schematics
    [decoupling_opamp.sch, decoupling_rail_splitter.sch, decoupling_resistor_divider.sch, gautebuoy.sch, hydrophone_suggested_decoupling.sch, power_12v.sch, power_24v.sch, preamp_12v.sch]
2012-08-10 protocol: fix gps status bug; increase max length of telegram to 256
    [protocol.py]
2012-08-11 increase timer
2012-08-12 bt: finally figured out gtk threads
2012-08-13 store: correct ref size
    [store.h]
2012-08-14 cleanup current loop
2012-08-15 zero, doc: protocol 3: send store version with each id and inf, store local version and remote version in dtt's
    [Protocol.ods]
2012-08-15 zero: correctly set storeversion
    [data.py]
2012-08-18 hw: start on symbols
    [gautebuoy.sch]
2012-08-18 protocol: handle errors from other buoys when on proto v1 buoy
    [protocol.py]
2012-08-19 zero: use events to avoid sleep in loop
    [index.py, protocol.py, zero.py]
2012-08-19 log: with threadname
2012-08-19 emit event on stop, to finish off current buoy loop
2012-08-19 buoy: remove all seialusb.prints except startupones
2012-08-19 zero: add ids incl lastid, shorter timeout on no getdatas
    [index.py, zero.py]
2012-08-19 upd local capacity budget for v 9
    [Local data capacity budget.ods]
2012-08-19 proto v 4
    [Protocol.ods]
2012-08-22 zero: dont race if only one buoy and all data uptodate, dont write index on exit - seems to reset..
    [buoys.py, data.py, zero.py]
2012-08-24 activate nogetdata shorter buoy timeout
    [zero.py]
2012-08-25 index: fix last id timeout
    [index.py]
2012-08-25 protocol: shorten debug messages
    [protocol.py]
2012-08-28 ads1282, gps: avoid using 1eN notation, does apparantly have something to do with floats..
    [ads1282.cpp, gps.cpp, gps.h]
2012-08-31 zero: rm faulty attempt at fixing something that wasnt a problem
    [zero.py]
2012-09-04 +5v reg
    [gautebuoy.sch]
2012-09-04 rf200: 3.3v, schem: ads1282evm
    [Olimexino - pin map and configuration.ods, gautebuoy.sch]
2012-09-04 complete schema
    [gautebuoy.sch]
2012-09-04 add frame
    [gautebuoy.sch]
2012-09-04 realign power rail
    [gautebuoy.sch]
2012-09-04 fix some wires, add olimexino ds
    [gautebuoy.sch]
2012-09-05 enhance schemas
    [Hydrophone_decoupling.sch, gautebuoy.sch, hydrophone_suggested_decoupling.sch]
2012-09-05 rn ads1282evm
    [gautebuoy.sch]
2012-09-12 schema: missing node connections
    [gautebuoy.sch]
2012-09-12 schema: align NC
    [gautebuoy.sch]
2012-10-09 mseed: bump to v2.7, use tracegroup
2012-10-10 tracegroup: groupheal
2013-01-13 getmoredats.sh: get dats for current station
2013-03-16 battery -> 72Ah
    [Power budget.ods]
2013-03-18 v bump
    [Hydrophone_decoupling.sch]
2013-03-18 add cap values and notes
    [Olimexino - pin map and configuration.ods, gautebuoy.sch]
2013-03-18 upd ref size
    [Local data capacity budget.ods]
2013-03-19 UART -> USART
    [Olimexino - pin map and configuration.ods]
2013-06-02 fix typo
    [Hydrophone_decoupling.sch]
2014-01-08 gps: revert to falling, unknown still: RFC2783
    [gps.cpp]
